ChrisG925/Proyecto3_Arquitectura_computadores/sim/layout_rom_60.png

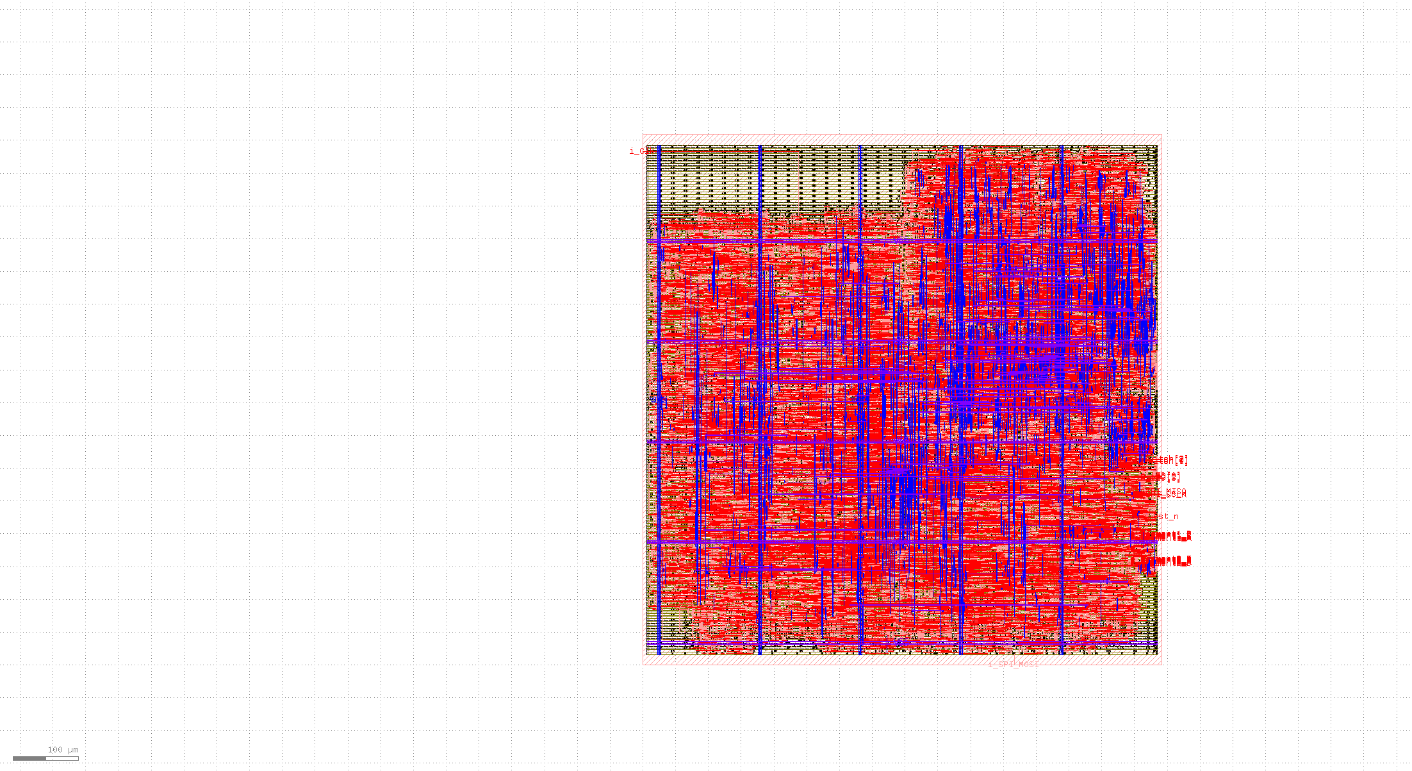
sim/layout_rom_60.png
