ChrisG925/Proyecto3_Arquitectura_computadores/(commit log)

2026-10-26 Base del Proyecto 2 para implementar ASIC
2026-10-30 Implementacion de ROM y RAM para ASIC
2026-10-30 Simulacion RTL ASIC con ROM y pruebas de botones
2026-11-01 Agregar scripts OpenROAD para visualizar contador y banco de registros
2026-11-01 Agregar configuraciones LibreLane para analisis ASIC
2026-11-01 Agregar script para generar modelos funcionales GF180MCU
2026-11-01 Excluir ejecutables compilados de simulacion
2026-11-01 Agregar configuraciones de pruebas de timing 67ns y 69ns
2026-11-01 Actualizar scripts OpenROAD para layout final de 100ns
2026-11-01 Agregar trazabilidad fisica de ALU en OpenROAD
2026-11-01 Eliminar configuracion temporal de reparacion fisica
2026-11-01 Mejorar reproducibilidad de trazabilidad ALU
